PignaPigni/Tankino/Source/Sito Web Tankino/img/tankino.png

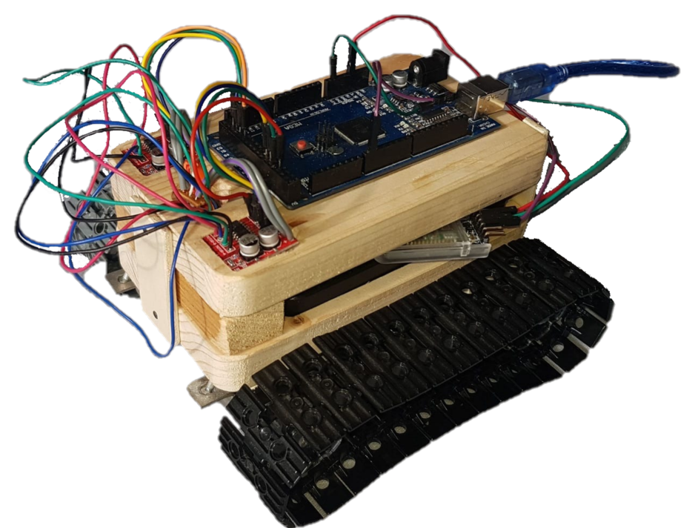
Source/Sito Web Tankino/img/tankino.png
