PignaPigni/Tankino/Documentazione/Documenti_Vari/Schema completo powerbank.jpeg

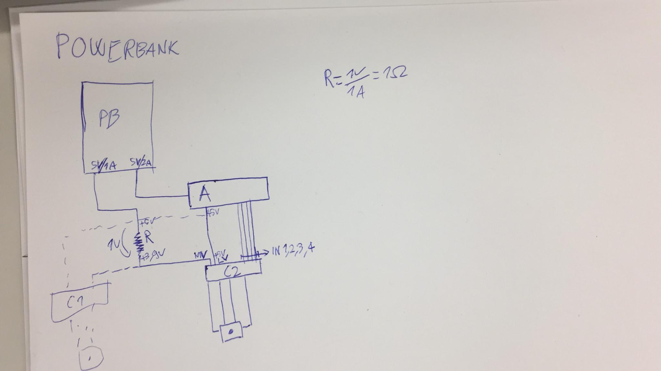
Documentazione/Documenti_Vari/Schema completo powerbank.jpeg
