PignaPigni/Tankino/README.md

# Tankino

## [Documentazione](/Documentazione/Documentazione.docx)

## [Sito](http://www.samtinfo.ch/i17fermos/Tankino/)
