PignaPigni/Tankino/Documentazione/Documenti_Vari/Links.txt

ESEMPIO DI TELAIO:
https://www.amazon.com/POLOLU-ROBOTICS-ELECTRONICS-CHASSIS-MOTORS/dp/B00DKYQ174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

https://www.amazon.com/s?k=tank+chassis+no+motor&ref=nb_sb_noss

NEMA - Pololu:
https://www.pololu.com/category/87/stepper-motors

NEMA 8 YT:
https://www.youtube.com/watch?v=i67KHlWYxyI

Drive a Stepper Motor with L298N | Arduino Tutorial:
https://www.youtube.com/watch?v=CE9G9uoYApI

KEYES L298N:
https://www.youtube.com/watch?v=ZdVkMaZqKXs

Stepper Motors with Arduino - Controlling Bipolar & Unipolar stepper motors:
https://www.youtube.com/watch?v=0qwrnUeSpYQ

KEYES L298:
https://www.google.com/search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

INGRANAGGIO CINGOLI:
https://brickset.com/parts/4582792/sprocket-%C3%B840-7

TO BUY:

L298N (13.99): 
https://www.amazon.it/Electrely-Bridge-Stepper-Controller-Arduino/dp/B07GFGS6BN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

Aukey PowerBank 10'000mah (15.99): 
https://www.amazon.it/AUKEY-Powerbank-10000mAh-Caricabatterie-Portatile/dp/B01NBRGY7N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

2x NEMA 8 Pololu (18): 
https://www.pololu.com/product/1204
