PignaPigni/Tankino/Documentazione/Documentazione.docx

# Introduzione

Informazioni sul progetto

Il progetto Tankino è stato realizzato da Adriano Chiriacò, Nicholas Pigni, Mosè Ferrazini e Michele Tomyslak alla Scuola Arti e Mestieri a Trevano durante la lezione del modulo 306.

I docenti responsabili sono:

- Luca Muggiasca (luca.muggiasca@edu.ti.ch)

- Geo Petrini (geo.petrini@edu.ti.ch)

La data d'inizio del progetto è il 17.01.2020 mentre la fine è prevista per il 08.05.2020.

## Abstract

In questo documento si possono trovare tutte le informazioni che riguardano lo sviluppo del progetto di Tankino. Più nel dettaglio si possono trovare informazioni su come abbiamo gestito la progettazione del nostro prodotto, i mezzi utilizzati, i requisiti da rispettare, come è avvenuta l’effettiva realizzazione, il design dell’applicazione, i vari protocolli di comunicazione e i test eseguiti.

## Scopo

Lo scopo del progetto Tankino è di realizzare un mini-carrarmato che sarà pilotabile grazie a un’applicazione disponibile per mobile. Il cuore centrale del nostro veicolo è un Arduino che servirà a controllare tutti i motori. Il controllo da remoto viene effettuato stabilendo una connessione Bluetooth.

# Analisi

## Analisi e specifica dei requisiti

Id requisito | Requisito | Priorità | Versione
REQ-001 | Avere un’applicazione mobile | 1 | 1.0
REQ-002 | Avere un Arduino funzionante | 1 | 1.0
REQ-003 | L’applicazione deve permettere di pilotare il veicolo | 2 | 1.0
REQ-004 | Essere in grado di fare un pairing Bluetooth | 2 | 1.0
REQ-005 | Il veicolo deve essere in grado di muoversi avanti e indietro | 2 | 1.0
REQ-006 | Il veicolo deve essere in grado di curvare | 3 | 1.0
REQ-007 | Il veicolo deve avere delle luci di controllo, gestibili da applicazione | 4 | 1.0
REQ-008 | Avere un sito dove scaricare le applicazioni | 3 | 1.0
REQ-009 | Il veicolo deve essere pilotato in tempo reale con la minor latenza possibile (misurata). | 3 | 1.0
REQ-010 | La velocità deve essere variabile | 4 | 1.0

## Use case

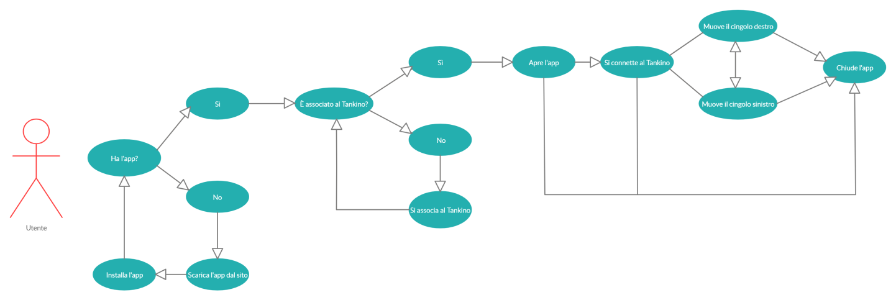
[picture p3: figure]

# Pianificazione

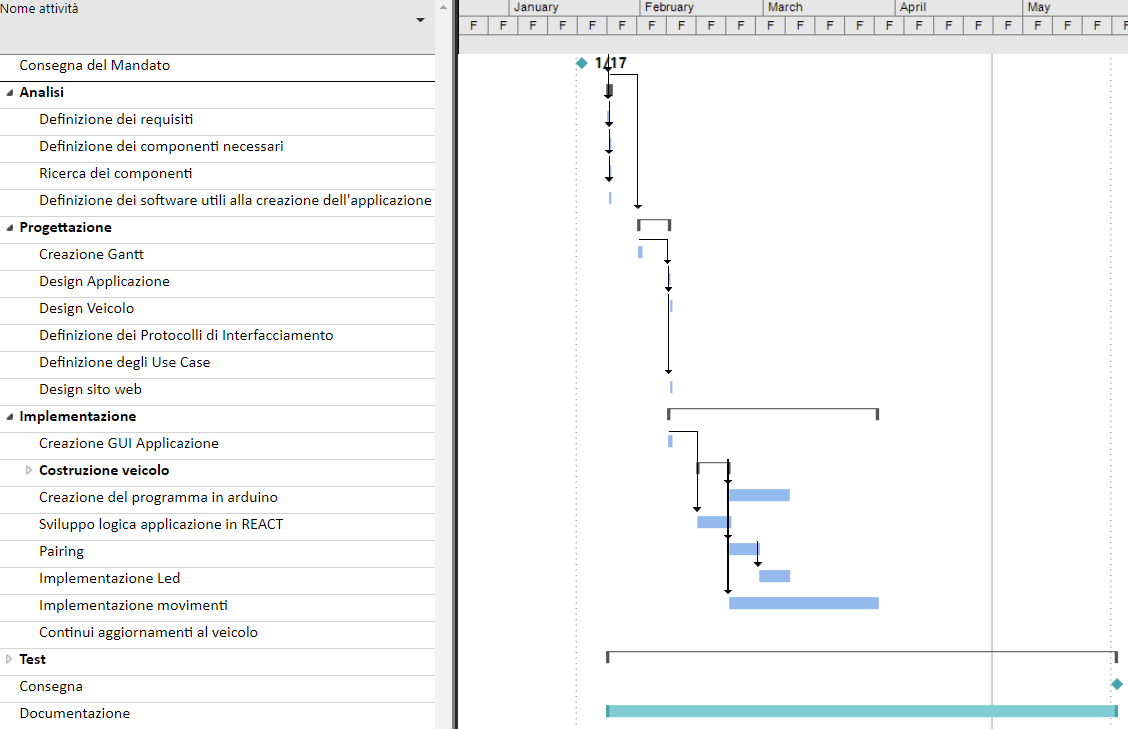
[picture p4: figure]

Per fare la pianificazione abbiamo creato un Gantt cercando di inserire all’interno tutte le attività che ci siamo posti, e suddividendocele.

Figura 1 Gantt

## Analisi dei mezzi

I mezzi da noi utilizzati per quanto riguarda la parte software e quindi la programmazione sono stati Android Studio e Arduino IDE. Per eseguire la creazione del Gantt abbiamo utilizzato un prodotto del pacchetto Office chiamato “Project” e un software libero chiamato “ProjectLibre”.

Mentre per quanto riguarda l’hardware ci siamo provvisti di due step motor “Nema 8”, di un powerbank “Aukey” da 10’000mah e due controller per gli step motor “L298N”.

Il programma per controllare il Tankino bisognerà avviarlo su un qualsiasi dispositivo android.

# Progettazione

La progettazione del nostro prodotto è variata tanto nel tempo, ma dopo varie considerazioni siamo arrivati a questa conclusione. La base fisica dal Tankino verrà realizzata in legno. Le ruote, prodotte in plexiglass, saranno collegate tra loro con dei cingoli. I cingoli che andremo ad utilizzare sono originali “lego”. Per quanto riguarda l’alimentazione utilizzeremo una powerbank con due uscite: una da 1v e 1a e una da 1v e 2a. Nella prima ci collegheremo l’Arduino mentre la seconda servirà ad alimentare i motori. All’Arduino ci sarà anche collegato un ricettore Bluetooth che servirà a controllare il Tankino tramite l’applicazione per smartphone. Inoltre, sempre all’Arduino, ci saranno collegati i due controller che gli permetteranno di gestire gli step motor. Per spiegare meglio tutta questa parte di elettronica abbiamo deciso di sviluppare uno schema elettrico.

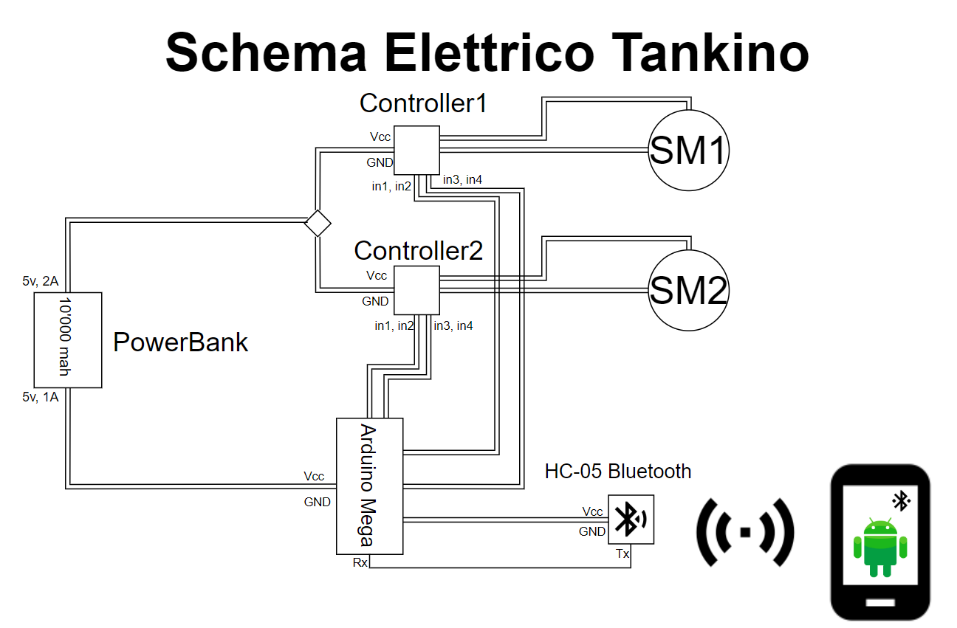
[picture p5: figure]

Protocollo di comunicazione

Un’altra cosa a cui abbiamo dovuto pensare è il protocollo di comunicazione tra l’applicazione all’Arduino tramite Bluetooth. La nostra idea è questa:

Messaggio | Nome | Descrizione
MSB = 0 0XXX XXXX | Cingolo destro | Il cingolo destro si muove in base alla percentuale data (da -100% a +100%) L’MSB determina che il cingolo che si deve muovere è il destro, il resto è il valore passato che è compreso nel range [-64;63] (oppure [0-127]). Il motore si muove in avanti se il valore è positivo e indietro se il valore è negativo.
MSB = 1 1XXX XXXX | Cingolo sinistro | L’MSB determina che il cingolo che si deve muovere è il sinistro, il resto è il valore passato che è compreso nel range [-64;63] (oppure [0-127]). Il cingolo si muove in avanti se il valore è positivo e indietro se il valore è negativo.

## Design

L’interfaccia dell’applicazione per mobile sarà molto semplice, sarà basata su due slider che permetteranno di gestire in modo autonomo i singoli motori. Ovviamente portando lo slider al massimo il motore raggiungerà la velocità massima e portandolo al minimo il motore sarà fermo. Questo è il design per quanto riguarda il design dell’applicazione:

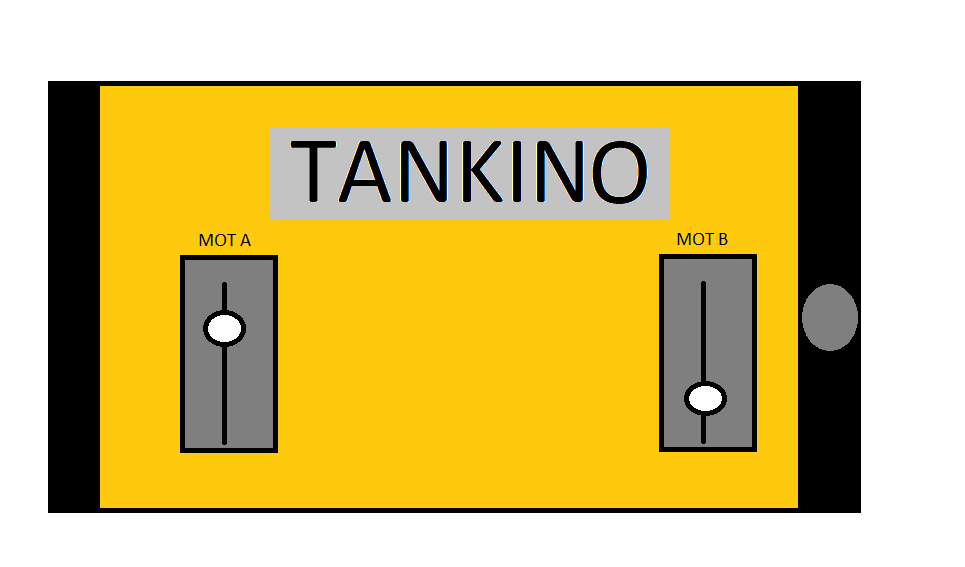
[picture p6: figure]

Figura 2 Progetto interfaccia app

Per quanto invece riguarda il design del Tankino vero e proprio sarà formato da due tavole di legno poste una sopra l’altra nel quale centralmente c’è un buco per far passare i cavi da sopra a sotto. Le ruote saranno realizzate in plexiglass e con dimensioni uguali tra loro.

# Implementazione

## Modulo HC-05

Per gestire il Bluetooth abbiamo utilizzato il modulo HC-05 e per implementarlo ci siamo basati su questo schema:

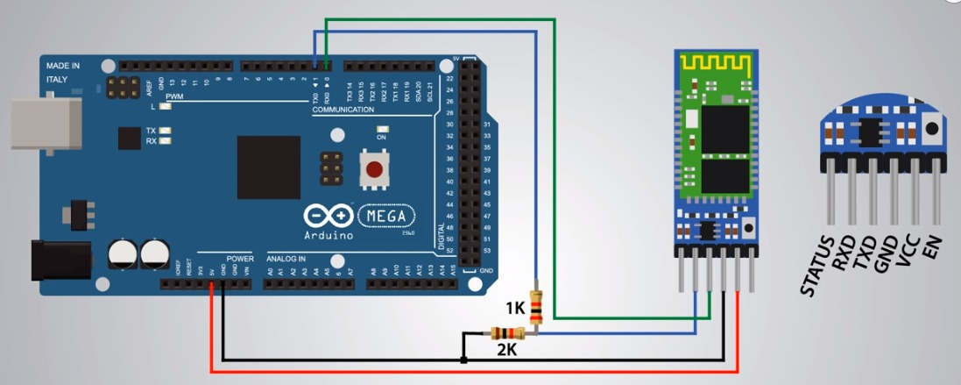
[picture p7: figure]

Figura 4 Schema Arduino-HC-05

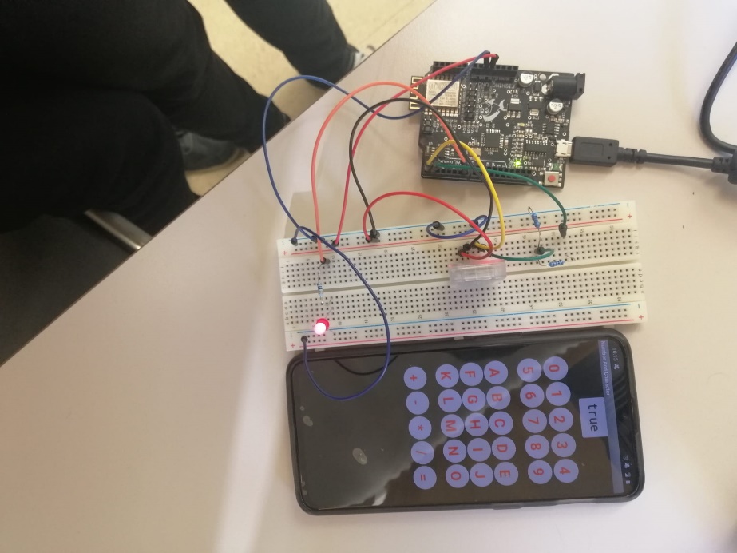
[picture p8: figure]

Collegando l’HC-05 all’Arduino in questo modo siamo in grado di comunicare con il dispositivo per il controllo remoto. La comunicazione tra i due componenti avviene tramite i pin RX e TX dell’Arduino.

Figura 5 Prime prove HC-05

Per fare le prime prove nell’utilizzarlo abbiamo semplicemente acceso e spento un led tramite un’applicazione trovata sul play store.

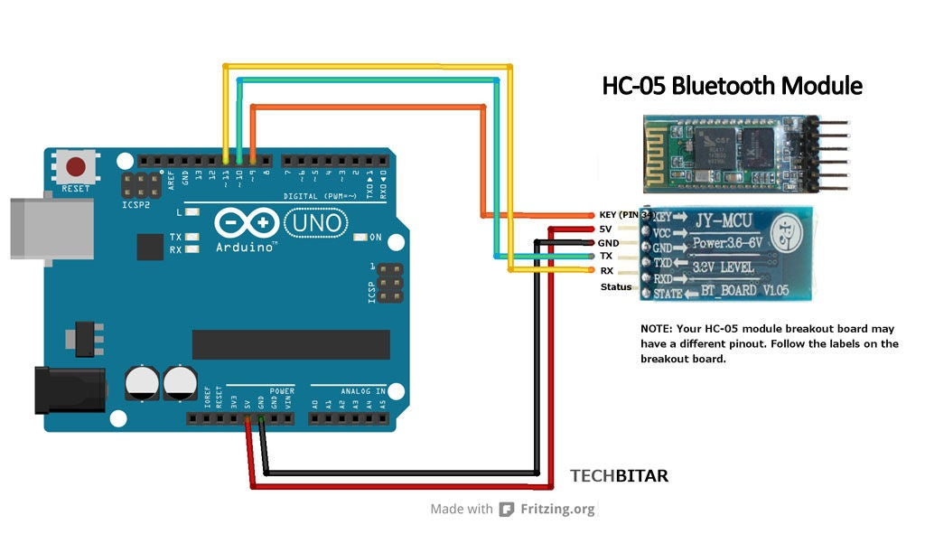
[picture p9: figure]

Dopodiché abbiamo rinominato il modulo HC-05 in “Tankino” per renderlo più riconoscibile alla connessione con il dispositivo mobile. Per farlo abbiamo dovuto utilizzare uno schema diverso perché per modificare il nome e le altre impostazioni del modulo bisogna attivare la “Command Mode”.

Figura 6 Schema HC-05 Command Mode

Seguendo questo schema abbiamo attivato la command mode e lo abbiamo impostato come volevamo grazie a dei comandi inseriti nella console seriale.

Per quanto riguarda il codice scritto su Android studio abbiamo creato una classe Thread per gestire gli slider chiamata CrowlerThread. Questa classe è stata implementata in modo da poter utilizzare nella main activity due slider che si occupano di assegnare ai motori la potenza desiderata. CrowlerThread inoltre invia anche i pacchetti di dati direttamene tramite Bluetooth al ricevitore dell’Arduino. A sua volta l’Arduino, tramite un protocollo precedentemente descritto, interpreta i dati e comunica con i controller degli step motor.

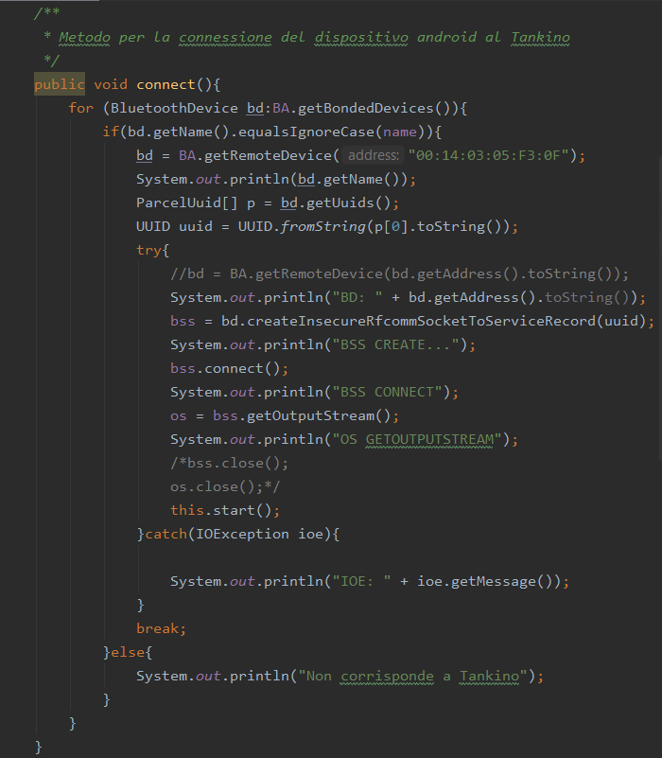
[picture p10: figure]

Il metodo connect invece viene invocato al click del button connect. Come prima cosa egesue un ciclo di tutti i dispositivi Bluetooth disponibili in cerca del ricevitore Bluetooth del Tankino. Una volta trovato stabilisce una connessione aprendo un canale stream di uscita e se non si verificano errori esegue la Thread che comincerà a mandare i dati degli slider.

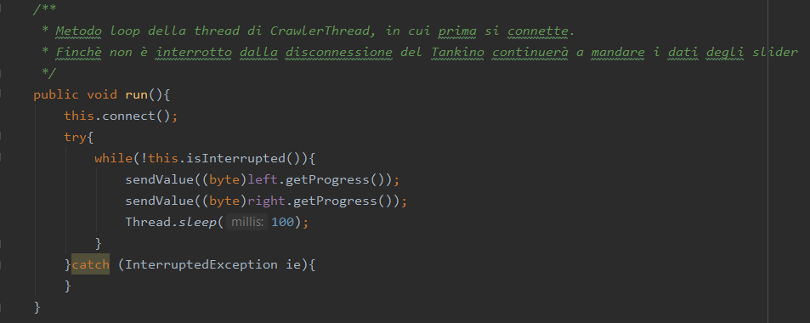
[picture p11: figure]

Il metodo run della classe CrowlerThread invia ogni 100 ms i dati in formato binario al Bluetooth dell’Arduino seguendo il protocollo prestabilito.

Ora invece passiamo al lato di programmazione svolto su Arduino.
Effettivamente in Arduino IDE abbiamo scritto il codice che tramite il protocollo di comunicazione traduce i dati ricevuti dal Bluetooth in grandezze utilizzabili come velocità per i motori.

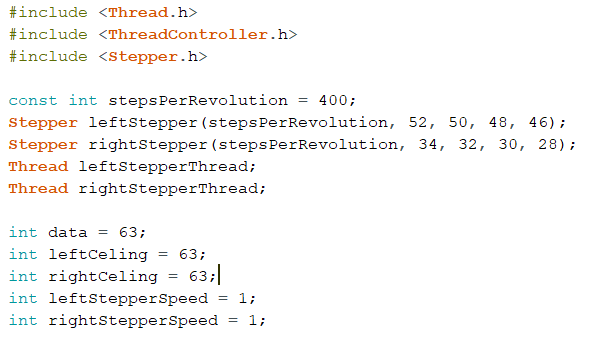
[picture p12: figure]

All’inizio del programma abbiamo importato le librerie necessarie per lo sviluppo. Infatti, per riconoscere un oggetto di tipo Stepper (rappresentazione logica dello step motor) si necessitava di scaricare e includere tale libreria (riga 3). Questo ci ha facilitato di molto il controllo dei motori; tramite i parametri passati alla creazione di un nuovo oggetto stepper (step per revolution, in1,in2,in3,in4) e i suoi due principali metodi (setSpeed(int) e step(int)) è stato un gioco da ragazzi.

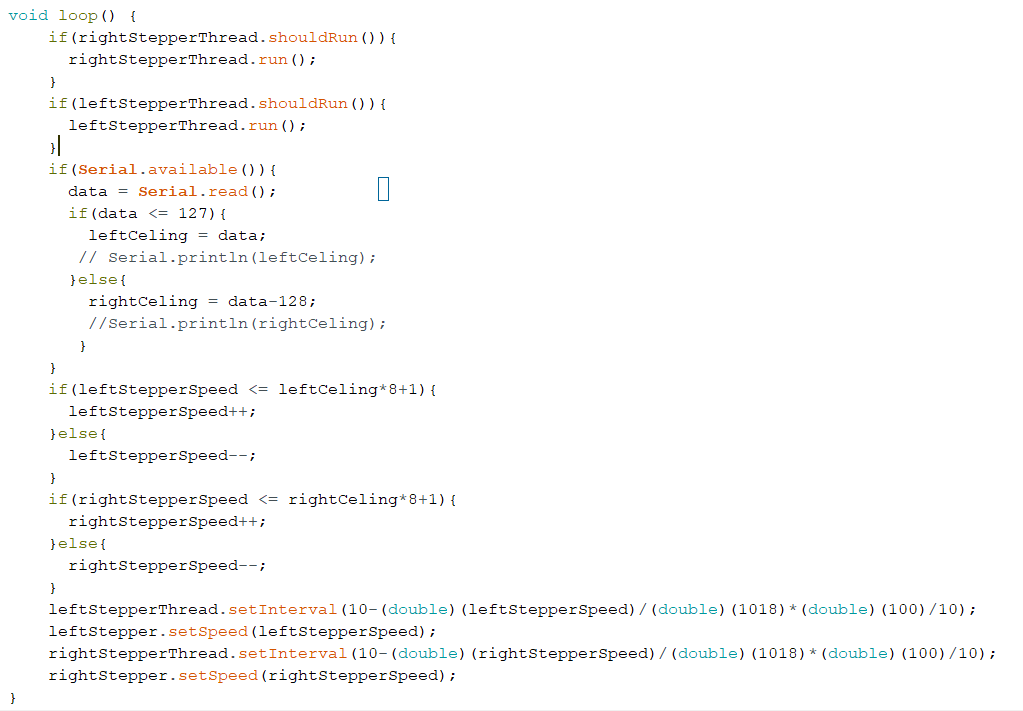
[picture p13: figure]

Per controllare singolarmente e senza interferenza i motori abbiamo dovuto utilizzare due Thread in modo che si muovano in modo asincrono.

Questa porzione di codice viene eseguita ripetitivamente durante tutto il ciclo di vita del programma. Qui avviene la vera propria traduzione dei dati ricevuti dal Bluetooth e il controllo dei motori. Innanzitutto, se necessario le due Thread vengono avviate. In seguito, si leggono i dati ricevuti e vengono modificati di conseguenza le velocità dei due motori.

Purtroppo, per modificare la velocità dei motori non basta impostarla nel metodo set speed ma bensì si deve richiamare con una frequenza consona il metodo step. Per fare ciò abbiamo utilizzato il metodo setInterval che varia l’intervallo tra una chiamata e l’altra al metodo step (in ms).

## Assemblaggio Tankino

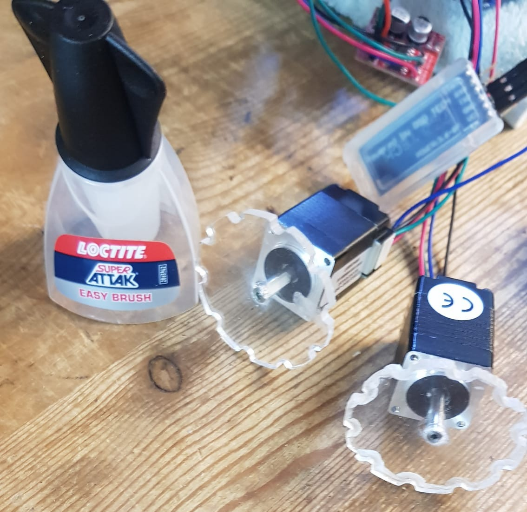
[picture p14: figure]

Grazie al contributo del professore Petrini abbiamo potuto avere dei pezzi su misura per il nostro Tankino. Abbiamo così ottenuto le due tavole di legno e le ruote in plexiglas.

Figura 7 Motori Nema 8 con ruote personalizzate

In questa foto si possono vedere le due incollate ai due motori nema 8.

Abbiamo preferito delle ruote personalizzate rispetto quelle lego per ragioni di estetica e di compatibilità con i motori.

Per quanto riguarda i cingoli invece abbiamo tenuto quelli lego e perciò anche la forma delle nostre ruote combacia in modo da aderire bene ad essi.

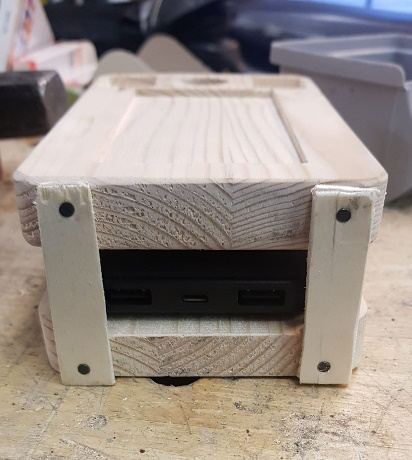
[picture p15: figure]
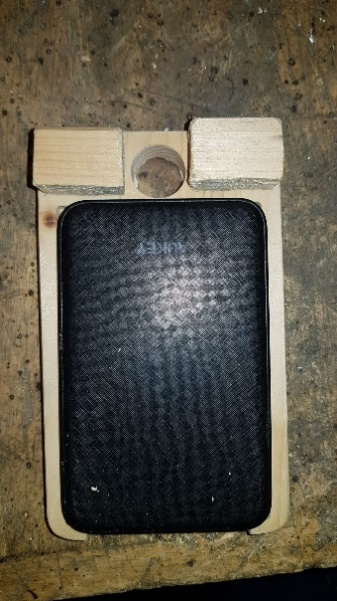
[picture p16: figure]

Passando alla base, nella parte inferiore c’è un’incavatura che permette l’inserimento della powerbank che alimenterà il Tankino.

Fatto ciò abbiamo attaccato la base superiore, essa presenta degli alloggi in cui fissare l’arduino mega e i controller.

Per stabilizzare ci siamo provvisti di due piccole assi di legno della lunghezza necessaria per lasciare la possibilità di utilizzare le porte della powerbank con facilità.

Figura 8 Base inferiore con powerbank

Figura 9 Basi attaccate con la powerbank all’interno

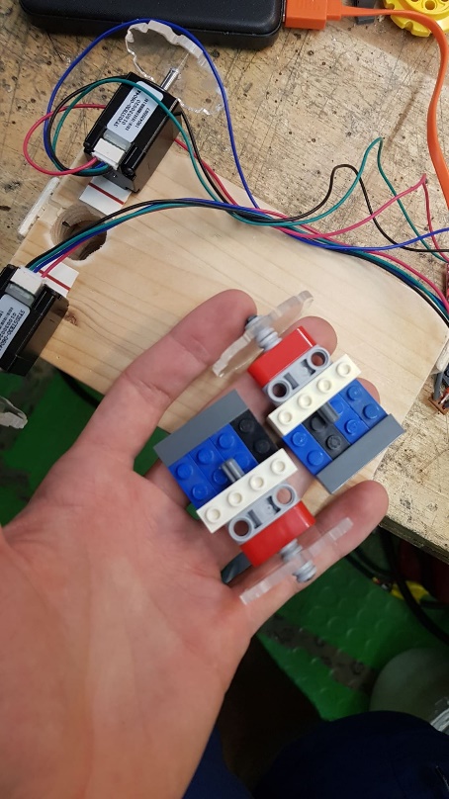
[picture p17: figure]
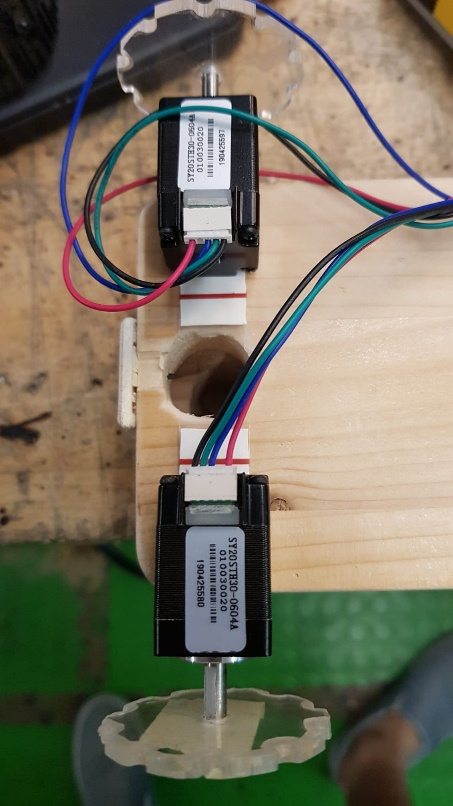
[picture p18: figure]

Successivamente abbiamo attaccato i motori sotto alla base inferiore.

Figura 10 Supporti ruote senza motore

Figura 11 Motori nema 8 affrancati sotto alla base inferiore

Inoltre, dato che i cingoli hanno bisogno di due ruote ciascuno per funzionare correttamente, abbiamo aggiunto due supporti senza motore.

Attivati a questo punto ci siamo accorti che c’era un ulteriore problema: un paio di ruote avevano una forma che non permetteva di far girare bene il cingolo. Per migliorare un po’ la situazione le abbiamo limate.

Il risultato finale della parte inferiore è questa.

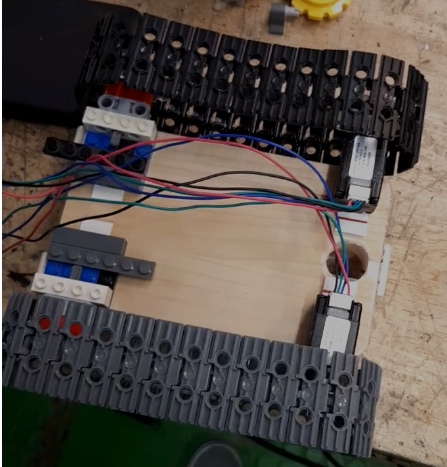
[picture p19: figure]

Figura 12 Motori e supporti assemblati con la base inferiore

Per quanto riguarda invece la parte superiore abbiamo affrancato l’Arduino utilizzando i buchi appositi mettendoci delle viti.
Per fare funzionare l’Arduino e i motori abbiamo ovviamente collegato il tutto all’alimentazione.

Questo è il risultato della parte superiore del Tankino.

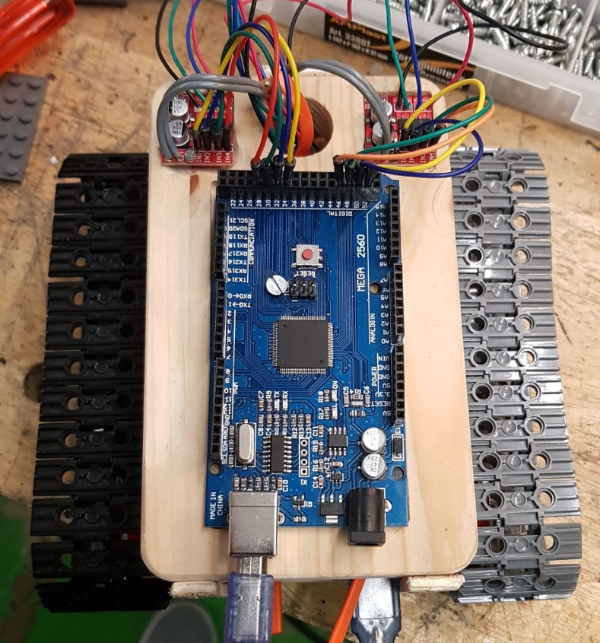
[picture p20: figure]

Figura 13 Risultato finale parte superiore Tankino

Con questo abbiamo terminato l’assemblaggio del Tankino, ed ora che è assemblato abbiamo scoperto che i motori sembrano non avere la potenza necessaria a far muovere il mezzo. Il risultato finale del Tankino è questo:

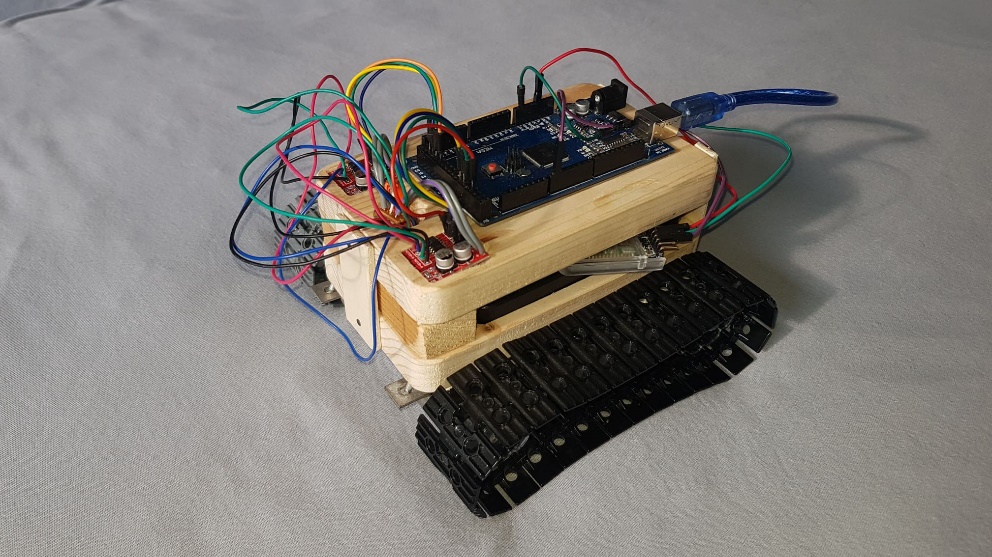
[picture p21: figure]

# Test

## Protocollo di test

Test Case | TC-001
Nome | Avere un’applicazione mobile Android
Riferimento | REQ-001
Descrizione | Test case per verificare di avere un’applicazione Android funzionante.
Prerequisiti | Avere un dispositivo Android.
Procedura | Installare l’applicazione tramite l’apk su un dispositivo Android e aprirla.
Risultati attesi | L’applicazione viene installata e aperta senza problemi.

Test Case | TC-002
Nome | Avere un’Arduino funzionante
Riferimento | REQ-002
Descrizione | Test case per verificare di avere un’Arduino funzionante.
Prerequisiti | Avere un pc a disposizione.
Procedura | Collegare l’Arduino al computer e provare a caricarci un programma.
Risultati attesi | L’Arduino viene individuato dal computer e esegue il programma correttamente.

Test Case | TC-003
Nome | Test guidabilità veicolo
Riferimento | REQ-003
Descrizione | Test case se L’applicazione permette di pilotare il veicolo
Prerequisiti | Essere connessi via Bluetooth al Tankino
Procedura | Connettere l’applicazione all’Arduino e provare a muovere entrambe gli slider sull’applicazione.
Risultati attesi | I cingoli del Tankino si muovono di conseguenza in base al valore degli slider dell’applicazione.

Test Case | TC-004
Nome | Pairing Bluetooth
Riferimento | REQ-004
Descrizione | Essere in grado di fare un pairing Bluetooth
Prerequisiti | Avere l’applicazione installata
Procedura | Aprire l’applicazione e cliccare sul tasto “connect”, il Bluetooth dovrebbe passare dal lampeggiare velocemente ad un lampeggio più lento. Se il collegamento è stato eseguito correttamente muovendo gli slider i cingoli si muoveranno di conseguenza.
Risultati attesi | Il Tankino risponde ai comandi dell’applicazione dopo essersi connesso.

Test Case | TC-005
Nome | Capacità di sterzata
Riferimento | REQ-006
Descrizione | Il veicolo deve essere in grado di curvare
Prerequisiti | Essere connessi via Bluetooth al Tankino
Procedura | Provare a impostare gli slider mettendo quello a sinistra a un livello superiore e poi fare il contrario.
Risultati attesi | Il cingoli del Tankino si muovono in singolarmente in base agli slider permettendo di eseguire delle curve.

Test Case | TC-006
Nome | Download applicazione
Riferimento | REQ-008
Descrizione | Avere un sito dove scaricare le applicazioni
Prerequisiti | Nessuno
Procedura | Andare sul sito ufficiale di Tankino e cliccare sul tasto download nella homepage.
Risultati attesi | Parte il download dell’applicazione.

Test Case | TC-007
Nome | Test velocità
Riferimento | REQ-010
Descrizione | La velocità deve essere variabile
Prerequisiti | Essere connessi via Bluetooth al Tankino
Procedura | Muovere gli slider verso l’alto e il basso
Risultati attesi | I motori del Tankino girano a velocità diversa in base al valore impostato con gli slider.

Test Case | TC-008
Nome | Il Tankino possiede delle luci di controllo
Riferimento | REQ-009
Descrizione | Le luci segnalano informazioni sullo stato del Tankino.
Prerequisiti | Montaggio di led che fungono da luci di controllo.
Procedura | Accendere il Tankino, connettersi tramite l’applicazione e muovere gli slider.
Risultati attesi | Le luci del Tankino cambiano in base al suo stato, girando a destra si accendono quelle di destra e a sinistra quelle di sinistra. Inoltre, alla connessione altre luci si accenderanno segnalando la corretta comunicazione tra applicazione e Arduino.

## Risultati test

Test Case | Riuscita (Sì - No) | Correzione
TC-001 | Sì | -
TC-002 | Sì | -
TC-003 | Sì | -
TC-004 | Sì | -
TC-005 | Sì | -
TC-006 | Sì | -
TC-007 | Sì | -
TC-008 | No | Le luci non sono state implementate sul Tankino.

## Mancanze/limitazioni conosciute

Alla fine di questo progetto ci troviamo con alcune lacune. Questo dovuto o alle mancanze di risorse o per mancanza effettiva di tempo. Il primo difetto, che è anche il più importante, è che effettivamente il Tankino non si muove; questo è dovuto a una potenza insufficiente dei motori. Se però il Tankino viene appoggiato sul dorso i motori funzionano, ma rimane una pecca, le ruote non eseguono la rotazione indietro. In secondo luogo, troviamo una mancanza per quanto riguarda i led di controllo i quali sono inesistenti sul Tankino.

# Consuntivo

Questo è il Gantt consuntivo delle attività svolte durante tutta la durata del progetto. Come si può notare non abbiamo avuto problemi ad arrivare in fondo alle varie attività previste nel Gantt di previsione, abbiamo però cancellato alcune attività essendo che per motivi tecnici siamo stati obbligati a cambiare metodo di sviluppo per l'applicazione mobile.

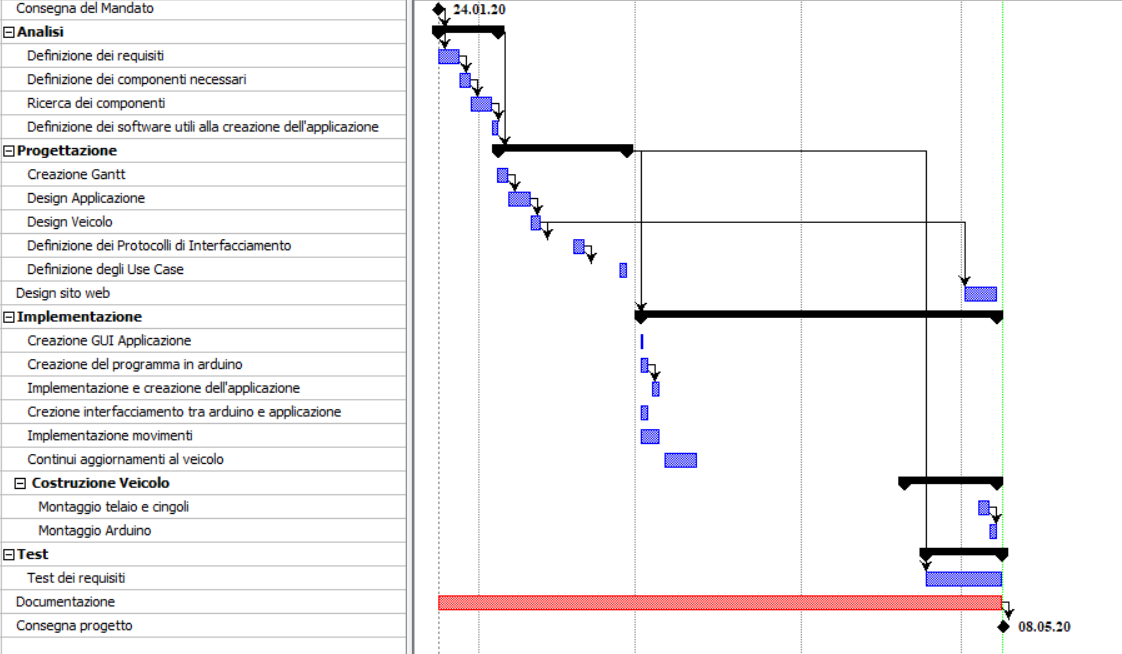
[picture p22: figure]

# Conclusioni

I risultati ottenuti sono per noi soddisfacenti nonostante il malfunzionamento del prodotto finale. Questo perché nonostante il lavoro sia stato realizzato ma con qualche malfunzionamento, la situazione in cui ci siamo trovati a lavorare per la faccenda Covid non era per nulla facile. Detto ciò ci riteniamo soddisfatti.

## Considerazioni personali

Grazie a questo progetto abbiamo imparato a gestire anche imprevisti e situazioni molto al limite che hanno interferito nel nostro percorso. Nonostante ciò non ci siamo abbattuti e abbiamo lavorato al meglio portando un risultato per noi molto buono. Abbiamo anche capito che la progettazione in un progetto così grosso è molto importante e noi non siamo stati molto precisi nel farla.

# Sitografia

Guida bluetooth (10.04.2020): https://developer.android.com/guide/topics/connectivity/bluetooth

Installer android studio (27.03.2020): https://developer.android.com/studio/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

Arduino IDE download(07.02.2020): https://www.arduino.cc/en/main/Software

Libreria stepper (27.03.2020): https://www.arduino.cc/en/reference/stepper

Tutorial multithread arduino(01.05.2020): https://create.arduino.cc/projecthub/reanimationxp/how-to-multithread-an-arduino-protothreading-tutorial-dd2c37

Tutorial HC-05(14.02.2020): https://www.youtube.com/watch?v=E-1w7dL3Cps

Tutorial command mode HC-05(06.03.2020): https://www.instructables.com/id/Modify-The-HC-05-Bluetooth-Module-Defaults-Using-A/

Template sito(01.05.2020): https://www.free-css.com/free-css-templates/page236/miapp

Nema 8: https://www.pololu.com/product/1204

HC-05: https://www.amazon.it/DSD-TECH-HC-05-pass-through-comunicazione/dp/B01G9KSAF6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

Powerbank: https://www.amazon.it/AUKEY-Powerbank-10000mAh-Caricabatterie-Portatile/dp/B01NBRGY7N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

# Allegati

In allegato a questo documento trovate i seguenti file:

- Diari di lavoro
- Sito web
