PignaPigni/Tankino/Documentazione/Tankino_Project.pdf

1 | Consegna del Mandato
2 | Analisi

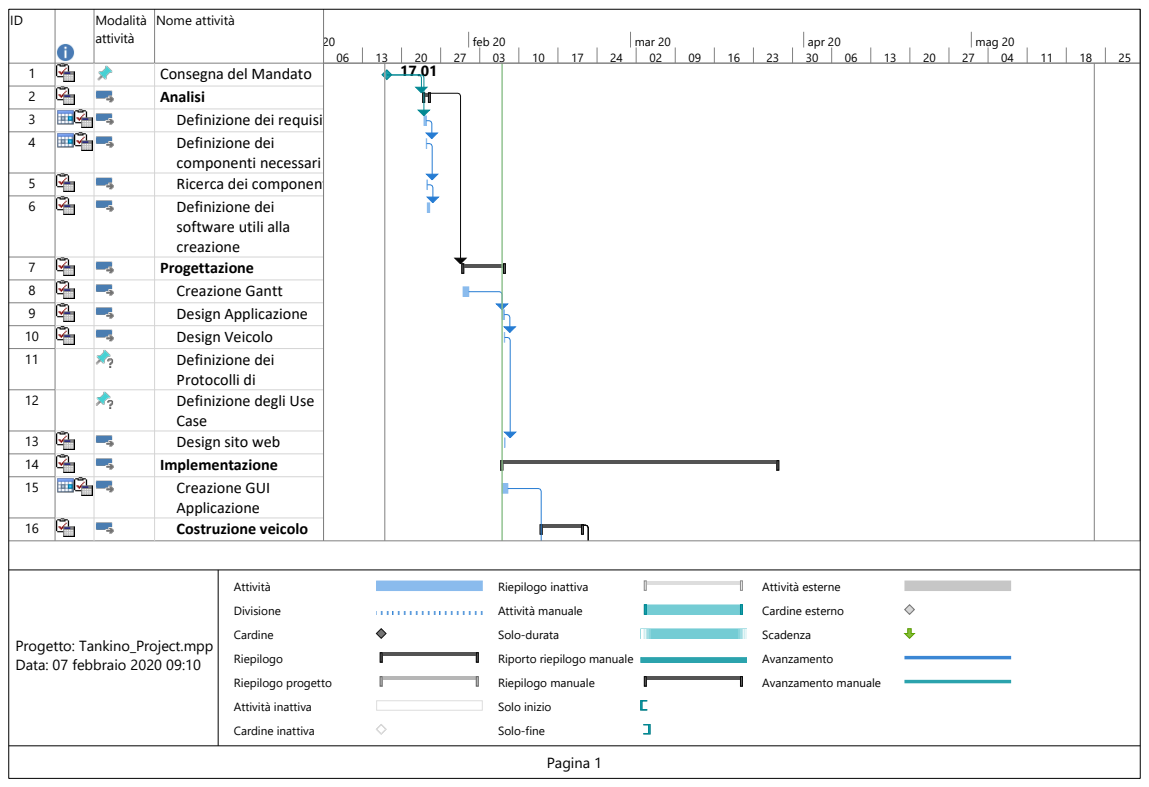
[picture p23: page 1]
Modalità; attività; Nome attività; Definizione dei requisiti; Definizione dei; componenti necessari; Ricerca dei componenti; Progettazione; Creazione Gantt; Design Applicazione; Design Veicolo; Protocolli di; Definizione degli Use; Case; Design sito web; Implementazione; Creazione GUI; Applicazione; Costruzione veicolo; gen 20; feb 20; mar 20; apr 20; mag 20; Attività; Divisione; Cardine; Riepilogo; Riepilogo progetto; Attività inattiva; Cardine inattiva; Riepilogo inattiva; Attività manuale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

software utili alla
creazione

Riporto riepilogo manuale

ID | Modalità attività Nome attività
19 | Creazione del programma in
20 | Sviluppo logica applicazione in REACT
21 | Pairing
22 | Implementazione Led
23 | Implementazione movimenti
24 | Continui aggiornamenti al
25 | Test
27 | Consegna
28 | Documentazione

22.05

06 | 13 | 20 | 27 | 03 | 10 | 17 | 24 | 02 | 09 | 16 | 23 | 30 | 06 | 13 | 20 | 27 | 04 | 11 | 18 | 25
gen 20 | feb 20 | mar 20 | apr 20 | mag 20

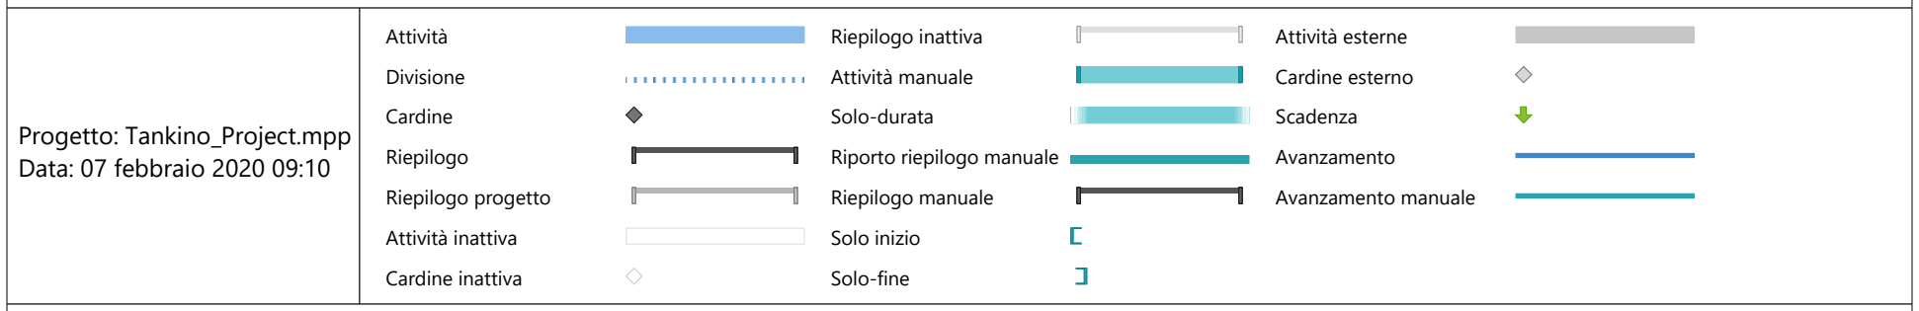
[picture p24: figure]
Attività; Divisione; Cardine; Riepilogo; Riepilogo progetto; Attività inattiva; Cardine inattiva; Riepilogo inattiva; Attività manuale; Solo-durata; Riporto riepilogo manuale; Riepilogo manuale; Solo inizio; Solo-fine; Attività esterne; Cardine esterno; Scadenza; Avanzamento; Avanzamento manuale; Progetto: Tankino_Project.mpp Data: 07 febbraio 2020 09:10

25 | 01 | 08 | 15 | 22 | 29 | 06 | 13 | 20 | 27 | 03 | 10 | 17 | 24 | 31 | 07 | 14 | 21 | 28 | 05 | 12 | 19 | 26 | 02 | 09 | 16 | 23 | 30 | 07
| giu 20 | | | | lug 20 | | | | | ago 20 | | | | set 20 | | | | ott 20 | | | | | nov 20 | | | | dic 20

22.05

25 | 01 | 08 | 15 | 22 | 29 | 06 | 13 | 20 | 27 | 03 | 10 | 17 | 24 | 31 | 07 | 14 | 21 | 28 | 05 | 12 | 19 | 26 | 02 | 09 | 16 | 23 | 30 | 07
| giu 20 | | | | lug 20 | | | | | ago 20 | | | | set 20 | | | | ott 20 | | | | | nov 20 | | | | dic 20
