PignaPigni/Tankino/Source/Sito Web Tankino/img/download.jpg

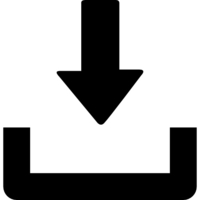
Source/Sito Web Tankino/img/download.jpg
