PignaPigni/Tankino/Source/Sito Web Tankino/img/tankino_app.PNG

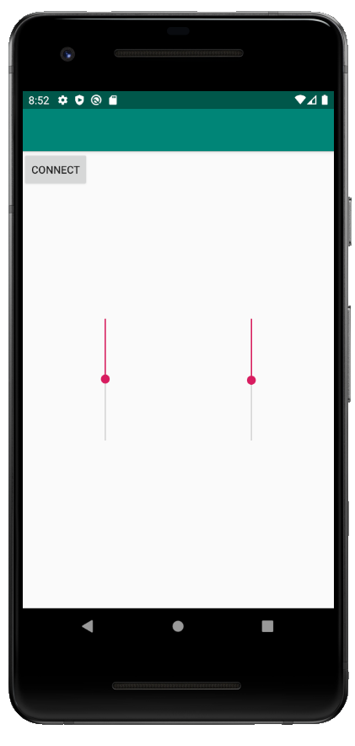
Source/Sito Web Tankino/img/tankino_app.PNG
