PignaPigni/Tankino/Documentazione/Documenti_Vari/57519.stl

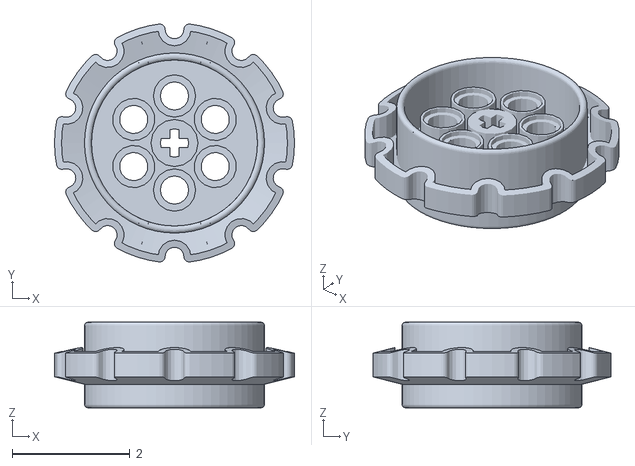
[picture p27: CAD file, 2020-03-06]
Documentazione/Documenti_Vari/57519.stl
4.08 x 4.05 x 1.46
