PignaPigni/Tankino/Documentazione/Diari/Tankino_Diario_2020.05.08.docx

# Tankino | Diario di lavoro

##### Mosè Ferrazzini, Michele Tomylsak, Adriano Chiriacò, Nicholas Pigni

### SAM Trevano, 08.05.2020

## Lavori svolti

Orario | Da chi | Lavoro svolto
08:20 – 16:30 | Adriano | Documentazione
08:20 – 16:30 | Nicholas | Pulizia codice, Foto Shooting al Tankino e aiuto documentazione
08:20 – 16:30 | Mosè | Messa a punto del sito e aggiunta foto
08:20 – 16:30 | Michele | Controllo dei criteri di valutazione

Oggi abbiamo tirato insieme tutto il materiale prodotto durante il progetto, la documentazione, immagini, codici. Inoltre abbiamo finito la documentazione e aggiunto delle foto del Tankino in azione sul campo.

## Alimentazione esterna dei controller

## Problemi riscontrati e soluzioni adottate

## Punto della situazione rispetto alla pianificazione

Siamo arrivati alla fine del progetto,

## Programma di massima per la prossima giornata di lavoro
