PignaPigni/Tankino/Documentazione/Diari/Tankino_Diario_2020.04.03.docx

# Tankino | Diario di lavoro

##### Mosè Ferrazzini, Michele Tomylsak, Adriano Chiriacò, Nicholas Pigni

### SAM Trevano, 03.04.2020

## Lavori svolti

Orario | Da chi | Lavoro svolto
08:20 – 16:30 | Adriano & Nicholas | Stesura del protocollo di comunicazione
08:20 – 16:30 | Michele & Mosè | Sviluppo applicazione

## Problemi riscontrati e soluzioni adottate

Ad un certo punto il componente del bluetooth ha smesso di funzionare per poi riprendere come se nulla fosse.

## Punto della situazione rispetto alla pianificazione

Ci troviamo leggermente dietro visto tutti i problemi legati al covid-19. Lavorare a distanza rende più lento il lavoro soprattutto visto che è molto pratico e richiede poca programmazione.

## Programma di massima per la prossima giornata di lavoro

Far funzionare il motore con il bluetooth e l’applicazione
