PignaPigni/Tankino/Documentazione/Diari/Tankino_Diario_2020.02.21.docx

# Tankino | Diario di lavoro

##### Mosè Ferrazzini, Michele Tomylsak, Adriano Chiriacò, Nicholas Pigni

### SAM Trevano, 21.02.2020

## Lavori svolti

Orario | Da chi | Lavoro svolto
8:20 – 16:30 | Michele & Mosé | Lavoro per cercare di far funzionare REACT
8:20 – 16:30 | Adriano & Nicholas | Ricerca programma per disegnare schema elettrico

## Problemi riscontrati e soluzioni adottate

## Nessuna assenza

## Punto della situazione rispetto alla pianificazione

## Programma di massima per la prossima giornata di lavoro
