PignaPigni/Tankino/(commit log)

2020-01-31 diario di lavoro
2020-02-07 Creato il file con tutti i links utili
2020-02-14 aggiunto test HC-05 al diario
    Documentato la prova del modulo bluetooth HC-05. Mosè
2020-02-14 Aggiunto problema riscontrato nel diario
    Aggiunto il problema dei pin RX e TX al diario. Mosè
2020-02-21 aggiunte documentazione
    - Corretto un errore nello scopo
    - Aggiunto la prima versione della lista dei requisiti
2020-02-21 Commit finale Venerdì 21.02.2020
    [57519.stl]
2020-03-06 aggiunto protocollo di comunicazione
    Aggiunto il protocollo di comunicazione tra telefono e arduino.
2020-03-27 Lavoro di oggi
    Implementato una base (quasi) stabile di interfaccia su android, risolvendo dei problemi con delle SDK di android non funzionanti, e corretti alcuni errori nel codice che portavano a delle NullPointerException
2020-04-03 Modifica Protocollo di comunicazione
2020-04-03 Sviluppo della GUI
    Implementati i 2 slider nell'interfaccia grafica
    e le basi della comunicazione con i motori sono state specificate
    Non funzionante -> sto risolvendo creando una nuova Thread, che spero permetta di mettere a posto il messaggio di warning del troppo uso della main thread, oltre a gestire meglio il loop per il flusso continuo e seriale dei dati
2020-04-10 Piluzia del codice, provato a fixare errore bluetooth
    Abbiamo provato tutti insieme a mettere a posto l'errore di connessuione dell'app al bluetooth ma non ci siamo ancora riusciti
    [StepperMotorTest.ino]
2020-04-10 Connessione al bluetooth dell'arduino funzionante
2020-04-10 Slider Funzionanti, passaggio dati corretto
    - Gli slider ora sono funzionanti
    - Aggiunta una classe Thread che gestisce l'invio dei dati
    - Abbiamo unito il programma arduino per muovere i motori e quello per il bluetooth, non è ancora funzionante
2020-04-10 Prova di ricevimento ed invio dati
2020-04-17 Lavoro sul problema di connessione bluetooth, non ancora messo a posto
    [StepperMotorTest.ino]
2020-04-24 Rimozione errori, Pulizia codice
    - Rimossi gli errori di collegamento bluetooth tra l'applicazione e l'arduino
    - Corretto le misure di velocità massima dello Stepper Motor
    [StepperMotorTest.ino]
2020-05-01 prima versione sito
    Ho iniziato a dare forma al sito, mancano ancora dei dettagli che non posso sistemare perché mi servono immagini e video.
2020-05-04 aggiunte documentazione
    Aggiunti test case 001 e test case 002
2020-05-04 Stepper motor singolarmente funzionanti
    Tramite dei Thread in arduino siamo riusciti a fare funzionare singolarmente ognuno dei due motori, in modo da poterli controllare dall'applicazione
2020-05-05 aggiornato scopo nella documentazione
    Cambiato la spiegazione dello scopo del progetto.
2020-05-05 aggiunto schema elettrico nella documentazione
    Ho aggiunto lo schema elettrico dei componenti elettrici del Tankino nella sezione di progettazione della documentazione e l'ho commentato .
2020-05-05 aggiunta documentazione sui pezzi su misura
    Ho aggiunto una parte di documentazione sui pezzi su misura ottenuti con l'aiuto del professore Petrini.
2020-05-06 cambiate immagini sul sito
    Ho cambiato delle immagini sul sito mettendo delle foto con la nostra applicazione.
2020-05-06 Errore che entrambi i motori girano nello stesso verso fixato
2020-05-06 documentato assemblamento Tankino
    Ho documentato l'assemblamento del Tankino
2020-05-07 Aggiunti i commenti e rimosso parti di codice non utilizzate
2020-05-07 Prove di funzionamento
2020-05-07 Pulizia codice Arduino e codice Java
2020-05-08 Cambiato il nome del file .ino da tankino.ino a tank.ino
2020-05-08 Pulizia del progetto di Android Studio
2020-05-08 Modifica Documentazione, aggiunta di test case e dei risultati dei Test Case
2020-05-08 aggiunti link al readme
    Ho aggiunto il link della doc e il link del sito al readme.
2020-05-08 Ordine nel Repository
    [57519.stl]
